AG-Schumann/Muon_Telescope_Remote_Control/docs/hardware/index.md

---
title: Hardware
nav_order: 2
has_children: true
---

# Hardware

The detector itself, and the control board that sits between it and the Raspberry Pi.
