AG-Schumann/Muon_Telescope_Remote_Control/docs/software/index.md

---
title: Software
nav_order: 3
has_children: true
---

# Software

A Python package in `software/`: a daemon that owns the hardware, a terminal UI that talks to it over a Unix socket, and the drivers underneath. Python 3.11+, installed into a virtual environment on the Pi.
