AG-Schumann/Muon_Telescope_Remote_Control/hardware/Schematics/Electronics/Board_Desing/Front Panel Desing.pptx

## Muon Telescope Control Board NIM Front Panel Desing

## Slide 2
