AG-Schumann/Muon_Telescope_Remote_Control/hardware/Schematics/Electronics/Board_Desing/Atmospheric_Muons.png

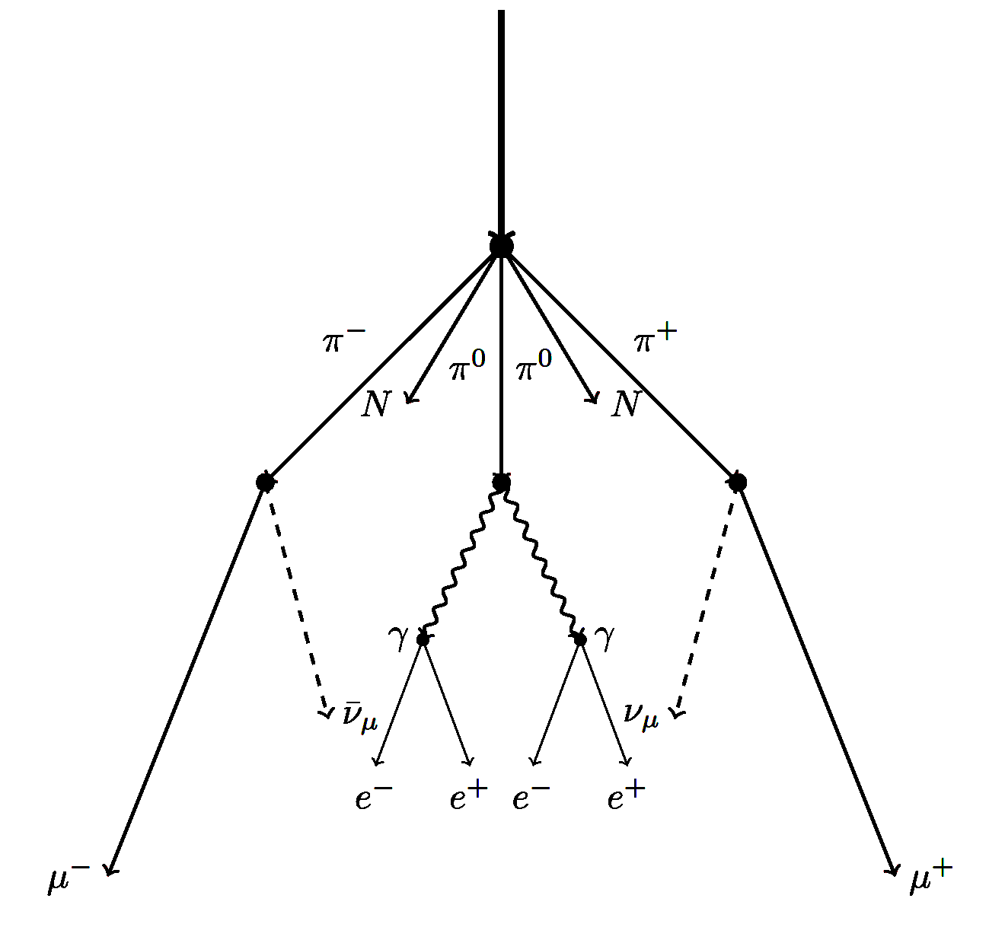
hardware/Schematics/Electronics/Board_Desing/Atmospheric_Muons.png
