AG-Schumann/Muon_Telescope_Remote_Control/hardware/Schematics/Frame_Movement/Bearing.jpg

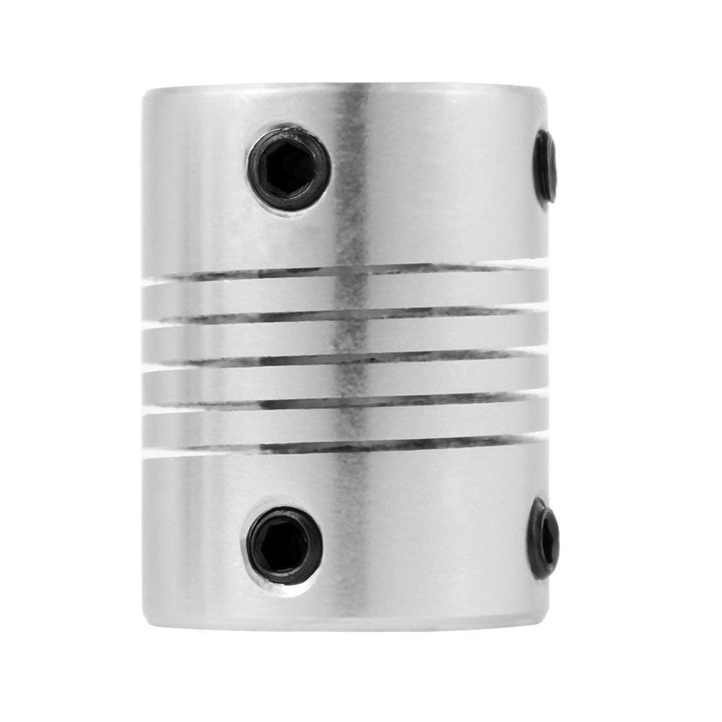
hardware/Schematics/Frame_Movement/Bearing.jpg
