AG-Schumann/Muon_Telescope_Remote_Control/hardware/Schematics/Frame_Movement/Drawing_1.jpeg

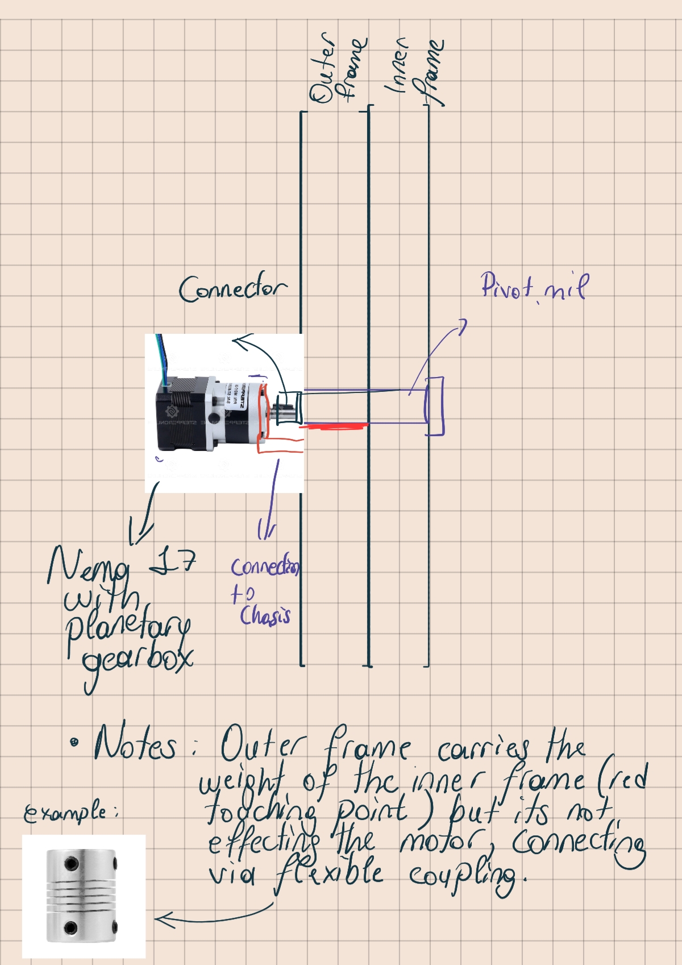
hardware/Schematics/Frame_Movement/Drawing_1.jpeg
