AG-Schumann/Muon_Telescope_Remote_Control/hardware/Schematics/Frame_Movement/Drawing_3.png

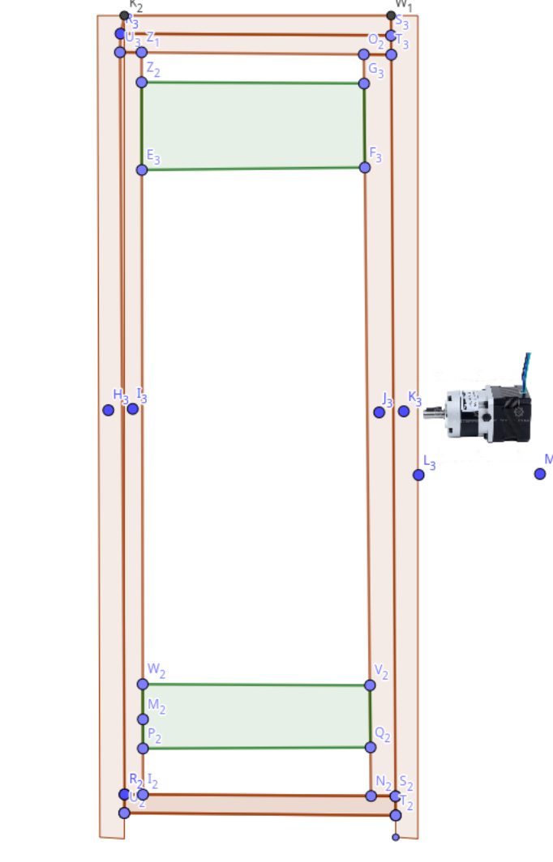
hardware/Schematics/Frame_Movement/Drawing_3.png
