AG-Schumann/Muon_Telescope_Remote_Control/hardware/Schematics/Frame_Movement/half view scintillator.png

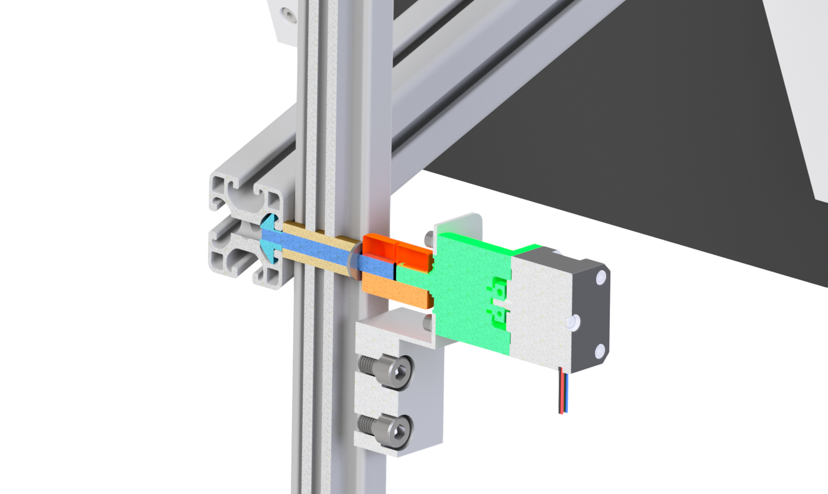
hardware/Schematics/Frame_Movement/half view scintillator.png
