AG-Schumann/Muon_Telescope_Remote_Control/hardware/Schematics/Frame_Movement/nema_17_with_gearbox_from_behind.jpg

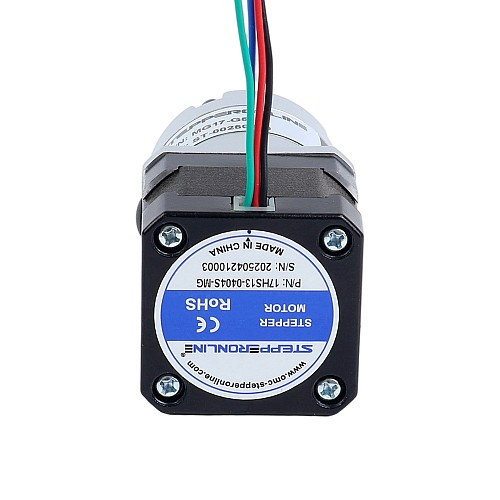
hardware/Schematics/Frame_Movement/nema_17_with_gearbox_from_behind.jpg
