AG-Schumann/Muon_Telescope_Remote_Control/hardware/Schematics/Frame_Movement/Rotating_System_Muon_Telescope.png

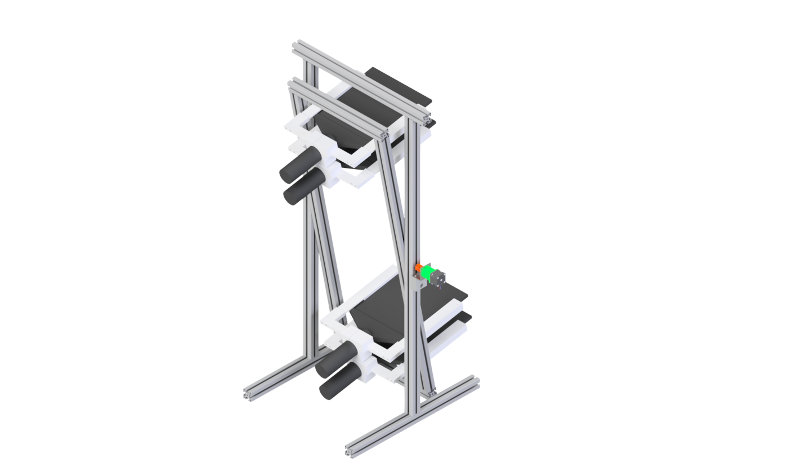
hardware/Schematics/Frame_Movement/Rotating_System_Muon_Telescope.png
