AG-Schumann/Muon_Telescope_Remote_Control/hardware/Schematics/Frame_Movement/scintillator shaft 2.png

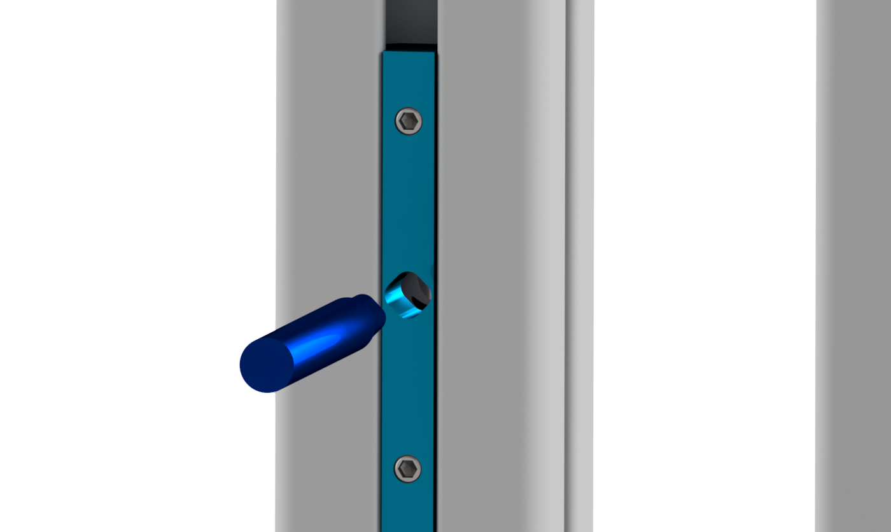
hardware/Schematics/Frame_Movement/scintillator shaft 2.png
