AG-Schumann/Muon_Telescope_Remote_Control/hardware/Schematics/Frame_Movement/view shaft.png

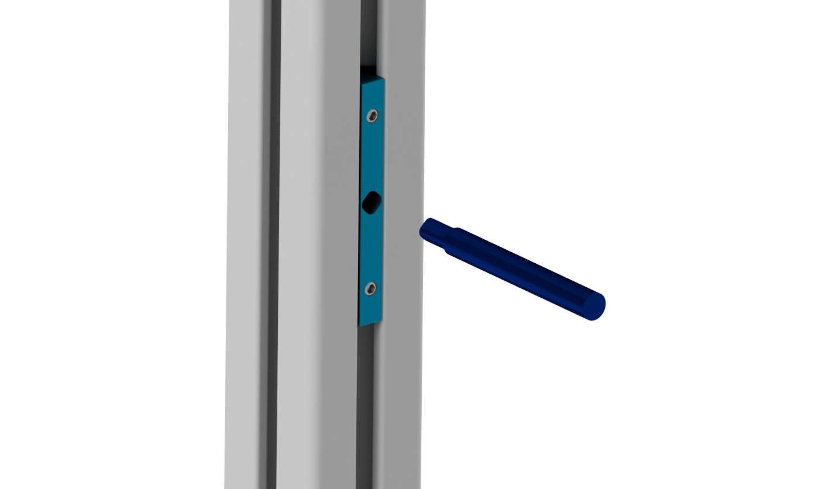
hardware/Schematics/Frame_Movement/view shaft.png
