AG-Schumann/Muon_Telescope_Remote_Control/hardware/Schematics/Measurement Setup/setup_images/ej-200-spec.jpg

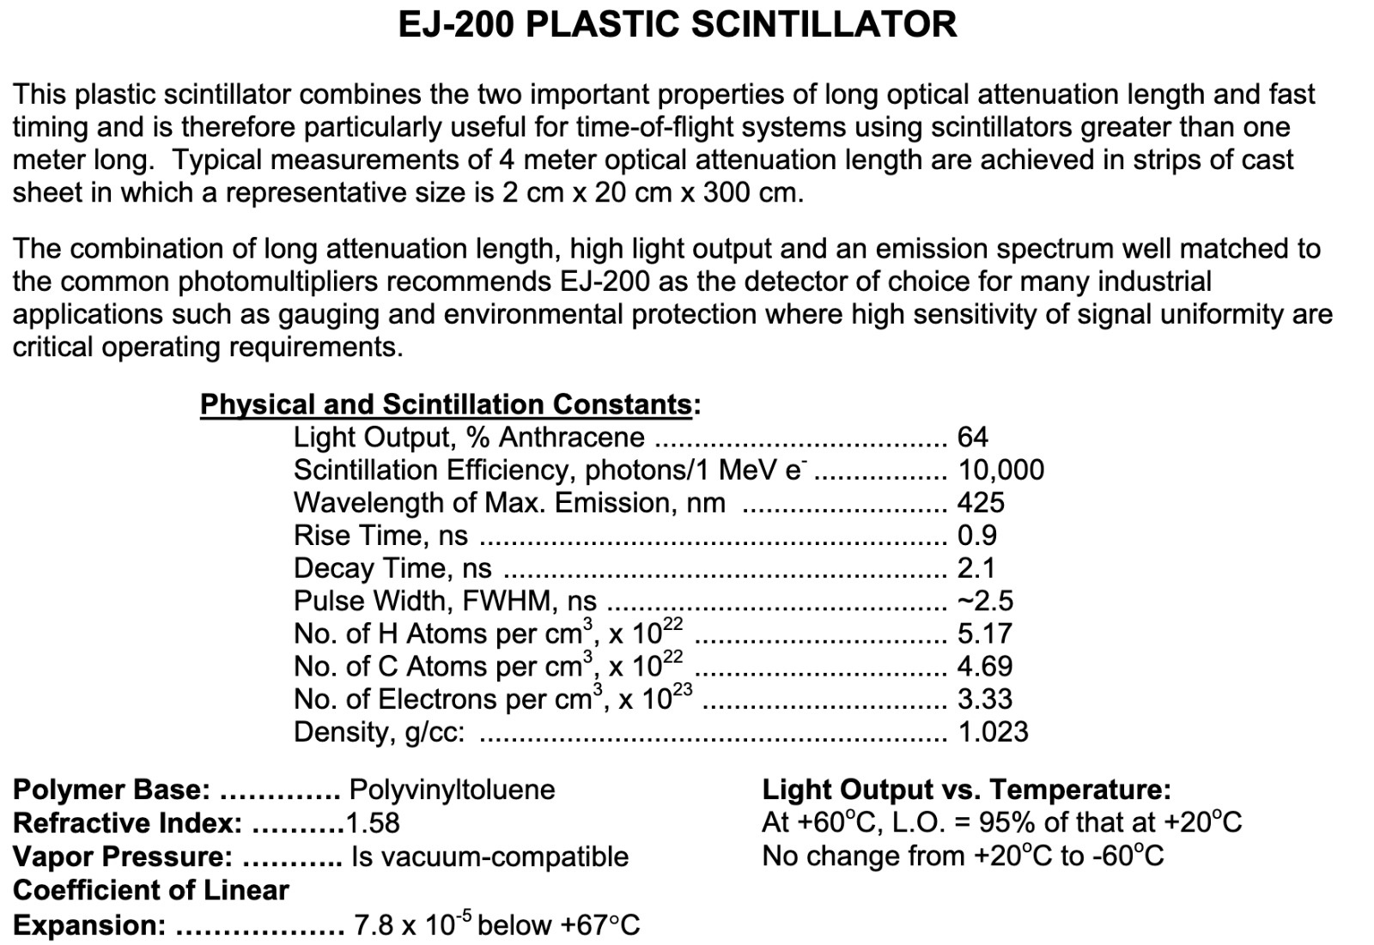
hardware/Schematics/Measurement Setup/setup_images/ej-200-spec.jpg
