AG-Schumann/Muon_Telescope_Remote_Control/hardware/Schematics/Electronics/Board_Desing/Board_Desing_V4.csv

Value | Reference | Footprint | Datasheet
33R | R13,R15 | Resistor_THT:R_Axial_DIN0207_L6.3mm_D2.5mm_P10.16mm_Horizontal
50R | R3,R14 | Resistor_THT:R_Axial_DIN0207_L6.3mm_D2.5mm_P10.16mm_Horizontal
100 nF | C2,C3,C4,C5,C6,C7 | Capacitor_THT:C_Disc_D5.0mm_W2.5mm_P5.00mm
330R | R8 | Resistor_THT:R_Axial_DIN0207_L6.3mm_D2.5mm_P10.16mm_Horizontal
470R | R10,R11,R12 | Resistor_THT:R_Axial_DIN0207_L6.3mm_D2.5mm_P10.16mm_Horizontal
1K | R4,R5,R6,R16,R17,R18,R20,R21,R22,R25,R26 | Resistor_THT:R_Axial_DIN0207_L6.3mm_D2.5mm_P10.16mm_Horizontal
10K | R23,R24,R27 | Resistor_THT:R_Axial_DIN0207_L6.3mm_D2.5mm_P10.16mm_Horizontal
2N7000 | Q1,Q2,Q3,Q4 | Package_TO_SOT_THT:TO-92 | https://www.vishay.com/docs/70226/70226.pdf
BAT85 | D1,D3 | Diode_THT:D_DO-34_SOD68_P7.62mm_Horizontal
BMI_Sensor_Conn | J2 | Connector_PinSocket_2.54mm:PinSocket_1x04_P2.54mm_Vertical
Coaxial_0 | J1 | Connector_Coaxial:LEMO-EPL.00.250.NTN
Coaxial_1 | J16 | Connector_Coaxial:LEMO-EPL.00.250.NTN
DAQ_DBG_0_1 | J14 | Connector_PinHeader_2.54mm:PinHeader_1x02_P2.54mm_Vertical
DAQ_DBG_0_2 | J15 | Connector_PinHeader_2.54mm:PinHeader_1x02_P2.54mm_Vertical
DAQ_DBG_1_1 | J17 | Connector_PinHeader_2.54mm:PinHeader_1x02_P2.54mm_Vertical
DAQ_DBG_1_2 | J18 | Connector_PinHeader_2.54mm:PinHeader_1x02_P2.54mm_Vertical
Driver_Socket | J19 | Connector_PinHeader_2.54mm:PinHeader_1x05_P2.54mm_Vertical
Front_Panel_Button_Conn | J10 | Connector_PinSocket_2.54mm:PinSocket_1x05_P2.54mm_Vertical
Front_Panel_Motor_Led_Conn | J11 | Connector_PinHeader_2.54mm:PinHeader_1x02_P2.54mm_Vertical
Front_Panel_Status_Led_Conn | J12 | Connector_PinSocket_2.54mm:PinSocket_1x04_P2.54mm_Vertical
Front_Panel_Toggle_Switch_Conn | J3 | Connector_PinHeader_2.54mm:PinHeader_1x02_P2.54mm_Vertical
GPIO | J8 | Connector_PinSocket_2.54mm:PinSocket_2x20_P2.54mm_Vertical
I2C_LCD_Conn | J13 | Connector_PinSocket_2.54mm:PinSocket_1x04_P2.54mm_Vertical
I2C_Temp_Conn | J20 | Connector_PinSocket_2.54mm:PinSocket_1x04_P2.54mm_Vertical
LIMIT_SWITCH_SET_0 | J4 | Connector_PinHeader_2.54mm:PinHeader_1x03_P2.54mm_Vertical
LIMIT_SWITCH_SET_MAX | J6 | Connector_PinHeader_2.54mm:PinHeader_1x03_P2.54mm_Vertical
P6KE6.8A | D2 | Diode_THT:D_DO-15_P10.16mm_Horizontal
Screw_Terminal_01x02 | J9 | TerminalBlock_Phoenix:TerminalBlock_Phoenix_MKDS-3-2-5.08_1x02_P5.08mm_Horizontal
SN74LVC1G14DBV | U1,U2 | Package_TO_SOT_SMD:SOT-23-5_HandSoldering | https://www.ti.com/lit/ds/symlink/sn74lvc1g14.pdf
Temp_Conn | J5 | Connector_PinHeader_2.54mm:PinHeader_1x03_P2.54mm_Vertical
