AG-Schumann/Muon_Telescope_Remote_Control/hardware/Schematics/Measurement Setup/setup_images/Cable_Labels.ods

Label List
HV |  | PMT-OUT
CH-0 | CH-0 | P0-OUT | P0-OUT
CH-1 | CH-1 | P1-OUT | P1-OUT
CH-2 | CH-2 | P2-OUT | P2-OUT
CH-3 | CH-3 | P3-OUT | P3-OUT
DISC->SCALER |  | PMT-OUT
P0-SC0 | P0-SC0 | P0-OUT | P0-OUT
P1-SC1 | P1-SC1 | P1-OUT | P1-OUT
P2-SC2 | P2-SC2 | P2-OUT | P2-OUT
P3-SC3 | P3-SC3 | P3-OUT | P3-OUT
DISC->COINC-4FOLD |  | DISC->COINC-2FOLD
P0-AND-4F | P0-AND-4F | P0-AND-03F | P0-AND-03F
P1-AND-4F | P1-AND-4F | P3-AND-03F | P3-AND-03F
P2-AND-4F | P2-AND-4F | P1-AND-12F | P1-AND-12F
P3-AND-4F | P3-AND-4F | P2-AND-12F | P2-AND-12F
FOLD-SCALER |  | 4F-PANEL-CONC
4F-SC | 4F-SC | 4F-AND-P1 | 4F-AND-P1
03F-SC | 03F-SC | P1-AND-4F | P1-AND-4F
12F-SC | 12F-SC | 4F-AND-P2 | 4F-AND-P2
4FP1-SC | 4FP1-SC | P2-AND-4F | P2-AND-4F
4FP2-SC | 4FP2-SC
