AG-Schumann/Muon_Telescope_Remote_Control/hardware/Schematics/Electronics/Board_Desing/Board_V2.stl

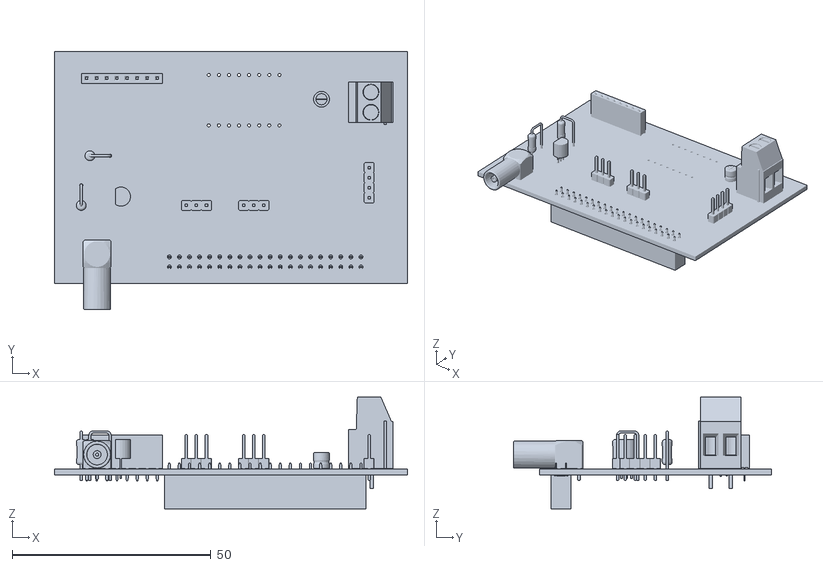
[picture p16: CAD file, 2026-10-29]
hardware/Schematics/Electronics/Board_Desing/Board_V2.stl
88.9 x 65.1 x 28.2
