AG-Schumann/Muon_Telescope_Remote_Control/hardware/Schematics/Frame_Movement/Models/Adapter für Steppermotor.stp

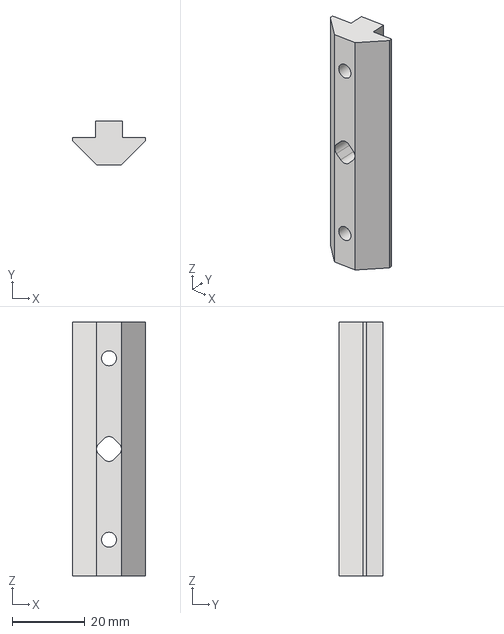
[picture p17: CAD file, 2026-10-29]
hardware/Schematics/Frame_Movement/Models/Adapter für Steppermotor.stp
20.0 x 12.0 x 70.0 mm
