AG-Schumann/Muon_Telescope_Remote_Control/hardware/Schematics/Frame_Movement/Models/Item 40x40x1200.stp

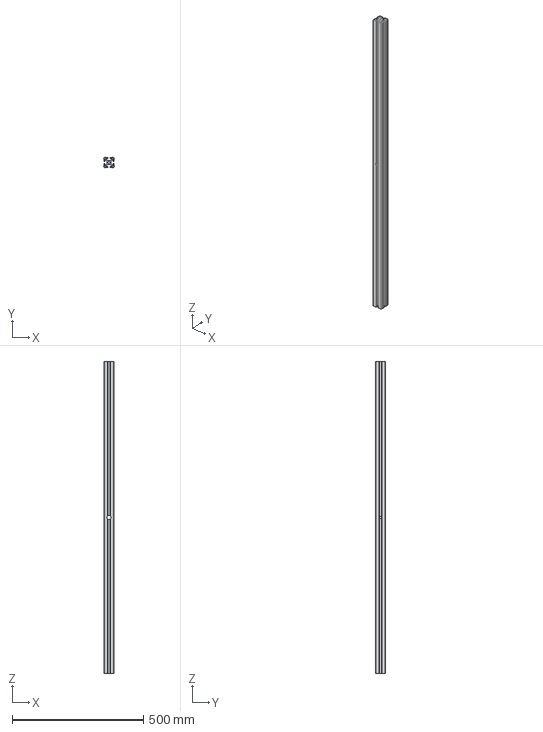
[picture p19: CAD file, 2026-10-29]
hardware/Schematics/Frame_Movement/Models/Item 40x40x1200.stp
40.0 x 40.0 x 1190.0 mm
