AG-Schumann/Muon_Telescope_Remote_Control/hardware/Schematics/Measurement Setup/Cad/RaspPi-4B.FCStd

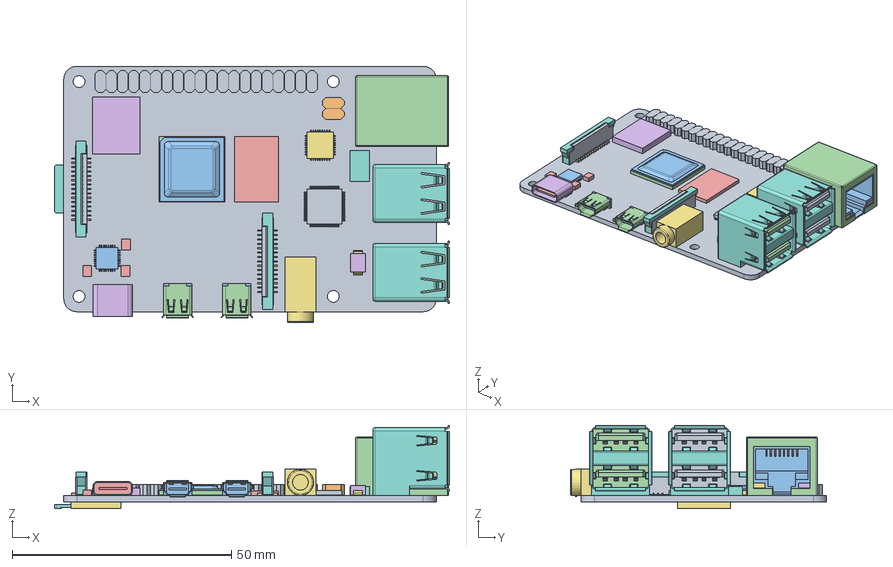
[picture p20: CAD file, 2026-10-29]
hardware/Schematics/Measurement Setup/Cad/RaspPi-4B.FCStd
90.1 x 58.5 x 19.0 mm
PCB
Chip Carrier
Heat Spreader
Solder
RAM (LPDDR4)
Radio
Package x 3
Pins x 6
Inductor x 3
Capacitor
Shield x 6
Network Wires
LED (yellow)
LED (green)
Pin Carrier x 2
Pins (Upper Connector) x 2
Pins (Lower Connector) x 2
Phone Socket (Audio/Video)
Holder x 2
SD Card Slot
Contacts
