AG-Schumann/Muon_Telescope_Remote_Control/hardware/Schematics/Frame_Movement/Models/Buchse Drehpunkt.stp

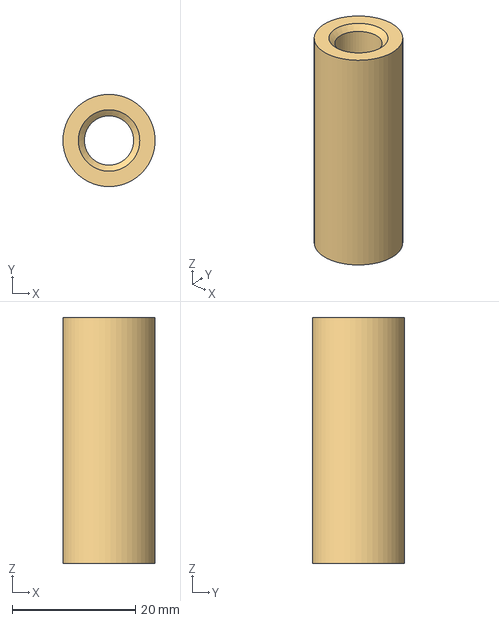
[picture p21: CAD file, 2026-10-29]
hardware/Schematics/Frame_Movement/Models/Buchse Drehpunkt.stp
15.0 x 15.0 x 40.0 mm
