AG-Schumann/Muon_Telescope_Remote_Control/hardware/Schematics/Measurement Setup/Cad/Muon_Detecotr.FCStd

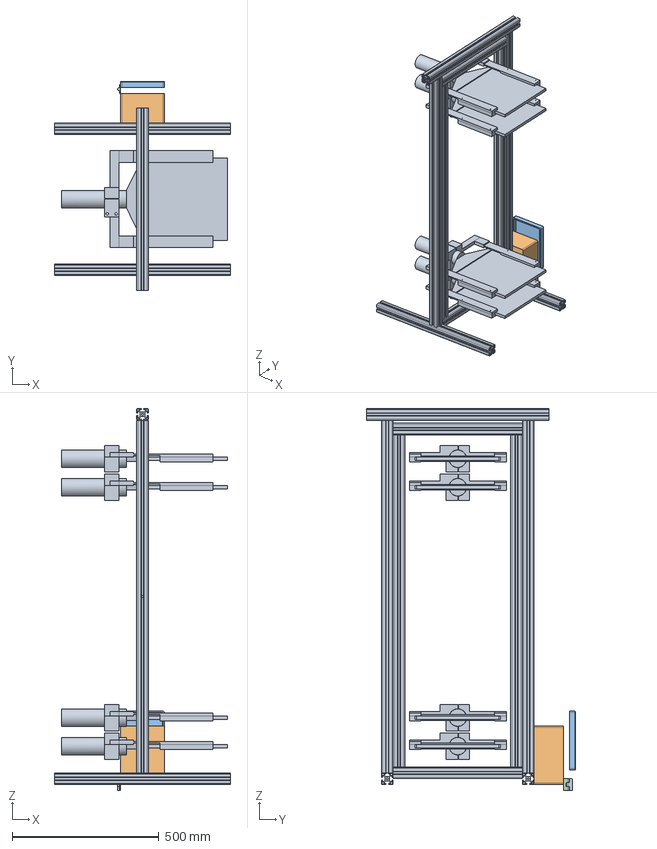
[picture p22: CAD file, 2026-10-29]
hardware/Schematics/Measurement Setup/Cad/Muon_Detecotr.FCStd
600.0 x 710.0 x 1300.0 mm
Scintillator group
Bottom_Part
Top_Part
Hinge_1
Hinge_2
Hinge_001
Hinge_002
Hinge_003
Hinge_004
