AG-Schumann/Muon_Telescope_Remote_Control/hardware/Schematics/Frame_Movement/Models/Drehteil Rotationswelle.stp

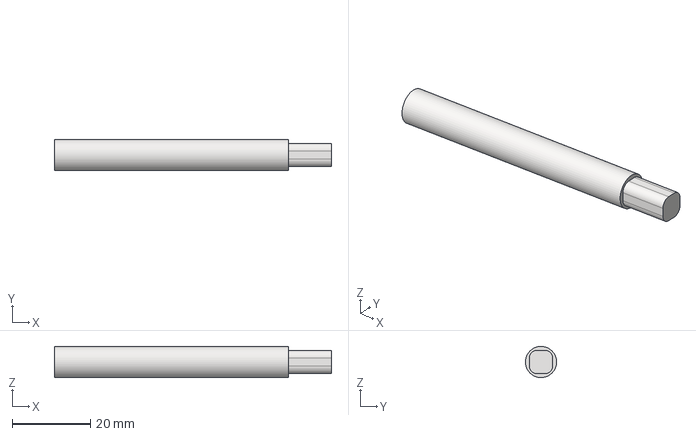
[picture p23: CAD file, 2026-10-29]
hardware/Schematics/Frame_Movement/Models/Drehteil Rotationswelle.stp
71.0 x 7.99 x 8.00 mm
