AG-Schumann/Muon_Telescope_Remote_Control/hardware/Schematics/Measurement Setup/Cad/TB6600.FCStd

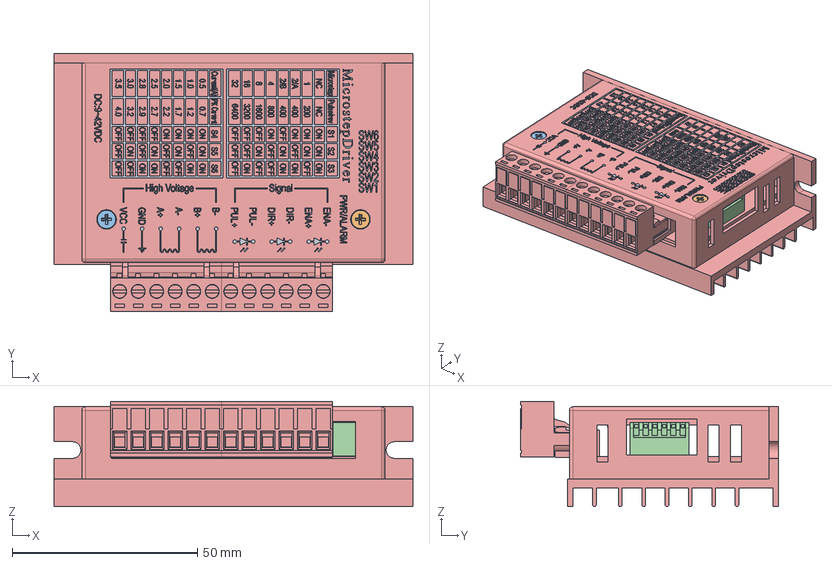
[picture p24: CAD file, 2026-10-29]
hardware/Schematics/Measurement Setup/Cad/TB6600.FCStd
97.0 x 69.6 x 28.5 mm
