AG-Schumann/Muon_Telescope_Remote_Control/(list of files, cad)

Other CAD files:
hardware/Schematics/Measurement Setup/Cad/Muon_Detector_Assembly.FCStd
hardware/Schematics/Electronics/Board_Desing/Board.FCStd
hardware/Schematics/Electronics/Board_Desing/TB6600.FCStd
hardware/Schematics/Measurement Setup/Cad/TB6600(AP203).step
