AG-Schumann/Muon_Telescope_Remote_Control/docs/operations/index.md

---
title: Operations
nav_order: 4
has_children: true
---

# Operations

Day-to-day running: monitoring, remote sessions, fetching the code, and what to do when something stops working.
