AG-Schumann/Muon_Telescope_Remote_Control/hardware/Schematics/Measurement Setup/setup_images/panel_layout_v2.pdf

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

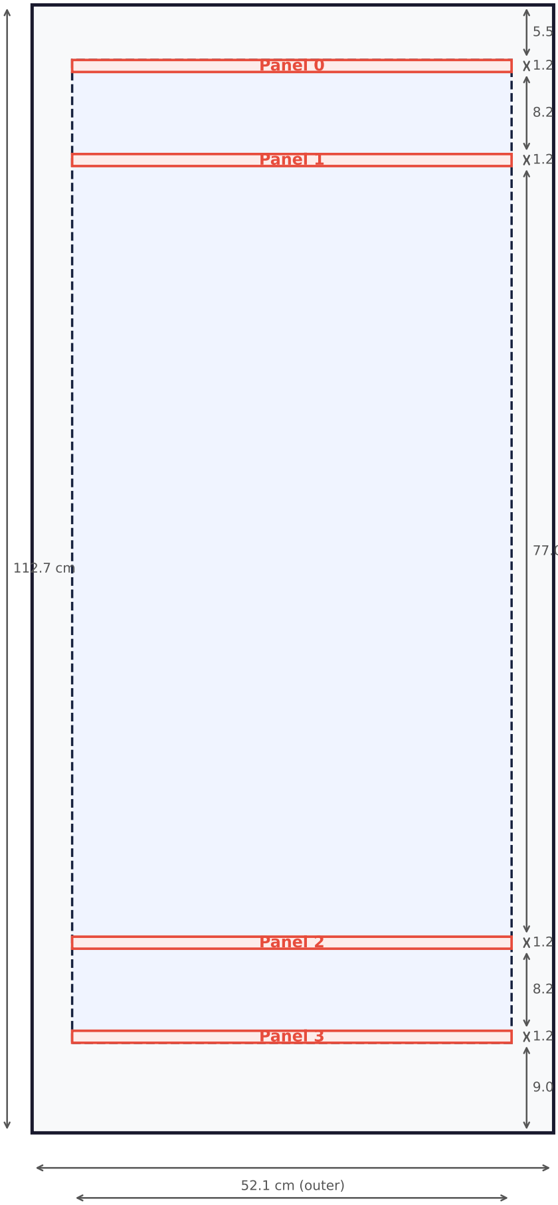
[picture p25: figure]
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
