AG-Schumann/Muon_Telescope_Remote_Control/hardware/Schematics/Measurement Setup/Cad/example_FC-View.png

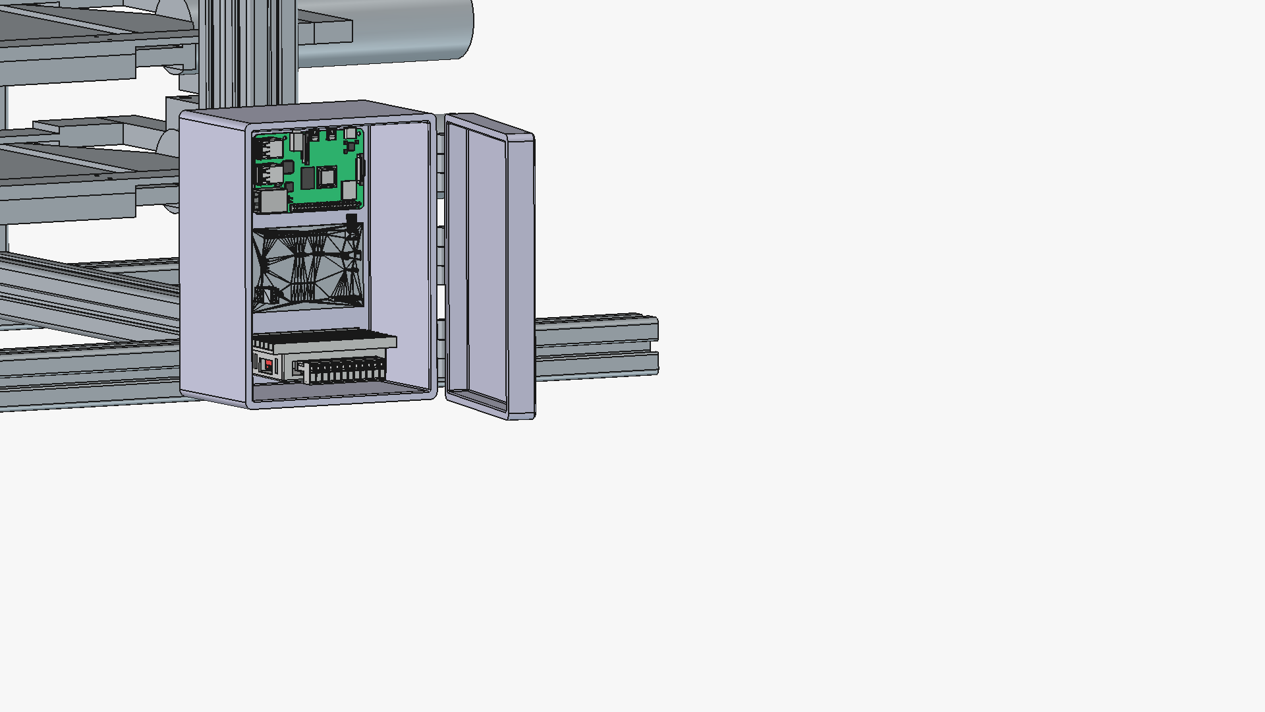
hardware/Schematics/Measurement Setup/Cad/example_FC-View.png
