AG-Schumann/Muon_Telescope_Remote_Control/hardware/Schematics/Measurement Setup/Cad/Outputs/Muon-Telescope-V2.png

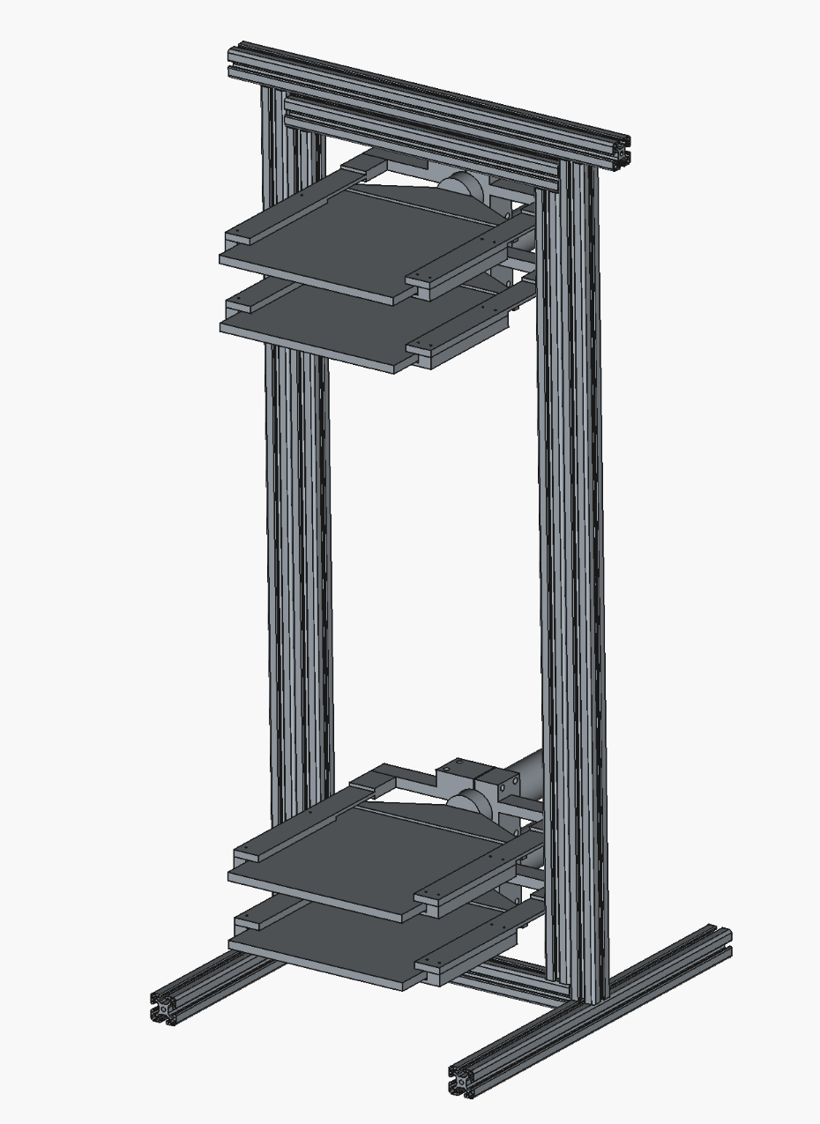
hardware/Schematics/Measurement Setup/Cad/Outputs/Muon-Telescope-V2.png
