AG-Schumann/Muon_Telescope_Remote_Control/hardware/Schematics/Measurement Setup/Cad/Outputs/Muon-Telescope-V2_4.jpg

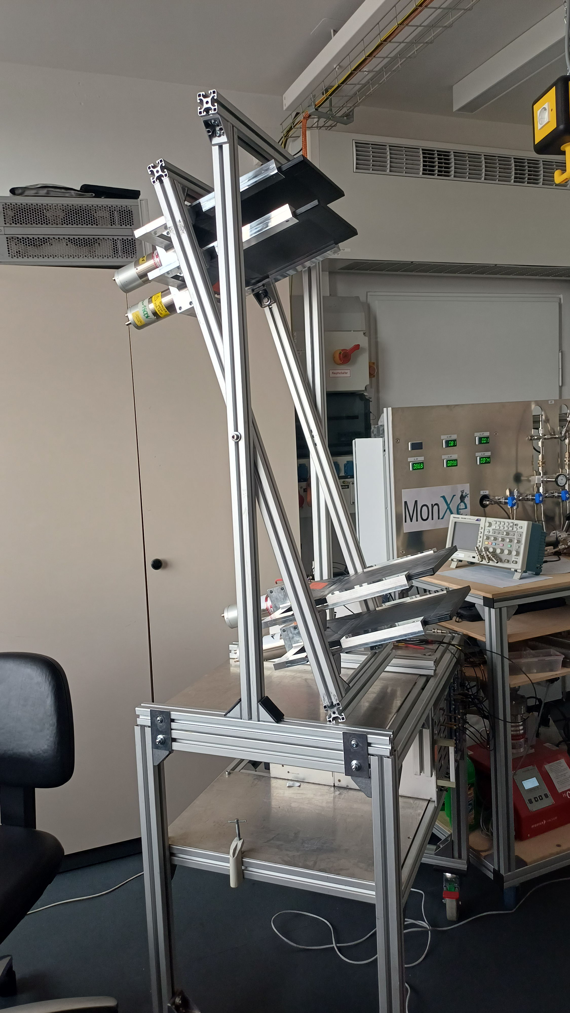
hardware/Schematics/Measurement Setup/Cad/Outputs/Muon-Telescope-V2_4.jpg
