AG-Schumann/Muon_Telescope_Remote_Control/hardware/Schematics/Measurement Setup/Panels/Panel_0/panel_0.jpg

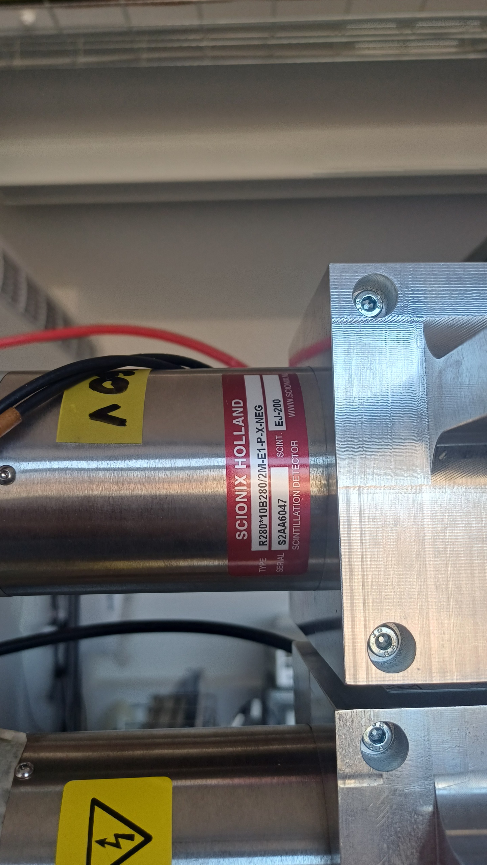
hardware/Schematics/Measurement Setup/Panels/Panel_0/panel_0.jpg
