AG-Schumann/Muon_Telescope_Remote_Control/hardware/Schematics/Measurement Setup/Panels/Panel_1/panel_1-1.png

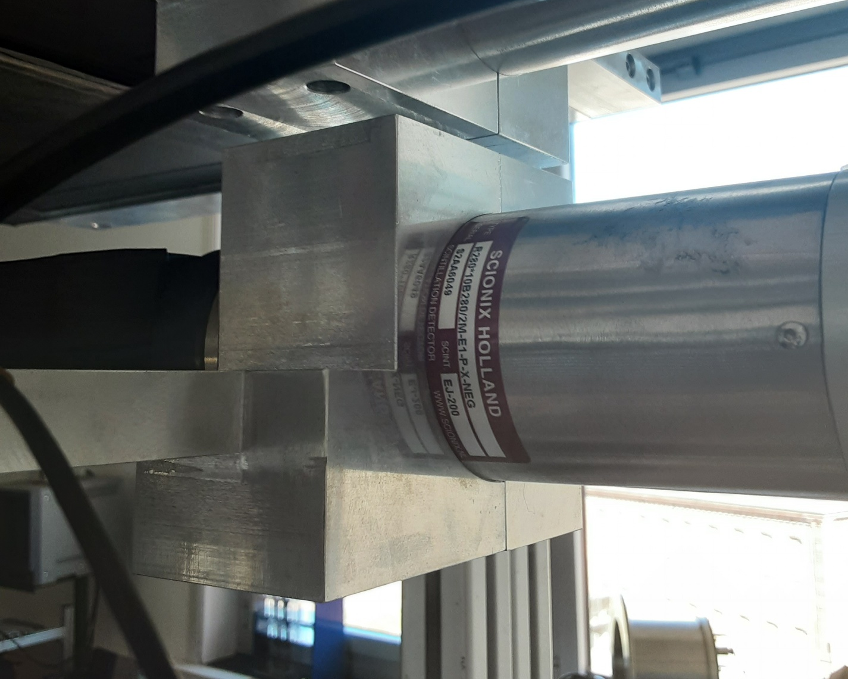
hardware/Schematics/Measurement Setup/Panels/Panel_1/panel_1-1.png
