AG-Schumann/Muon_Telescope_Remote_Control/hardware/Schematics/Measurement Setup/Panels/Panel_1/panel_1-2.png

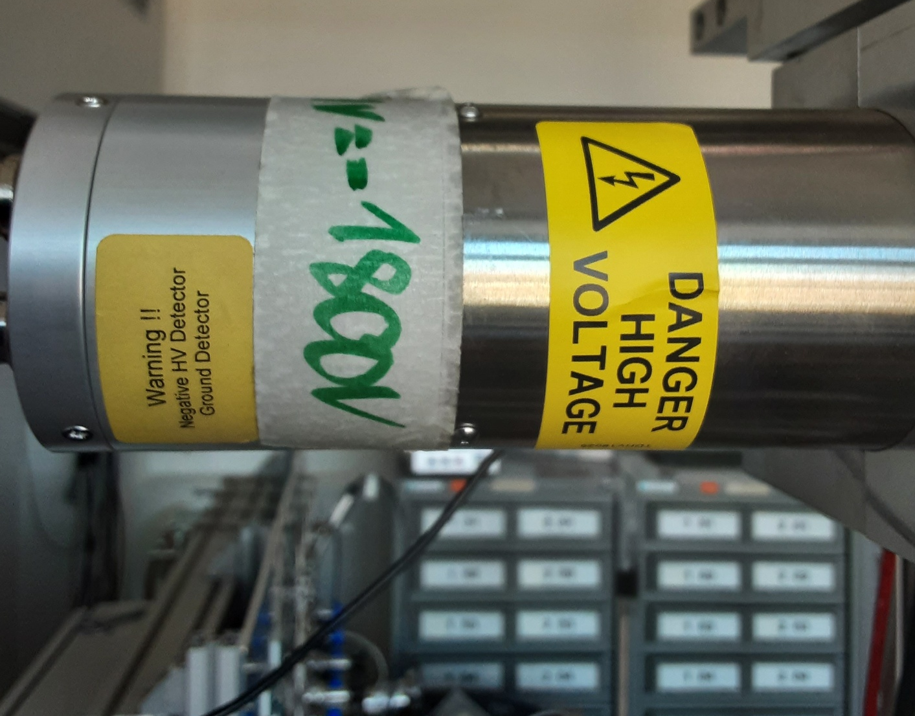
hardware/Schematics/Measurement Setup/Panels/Panel_1/panel_1-2.png
