AG-Schumann/Muon_Telescope_Remote_Control/hardware/Schematics/Measurement Setup/Panels/Panel_1/panel_1_muon_sig_osci_disc.jpeg

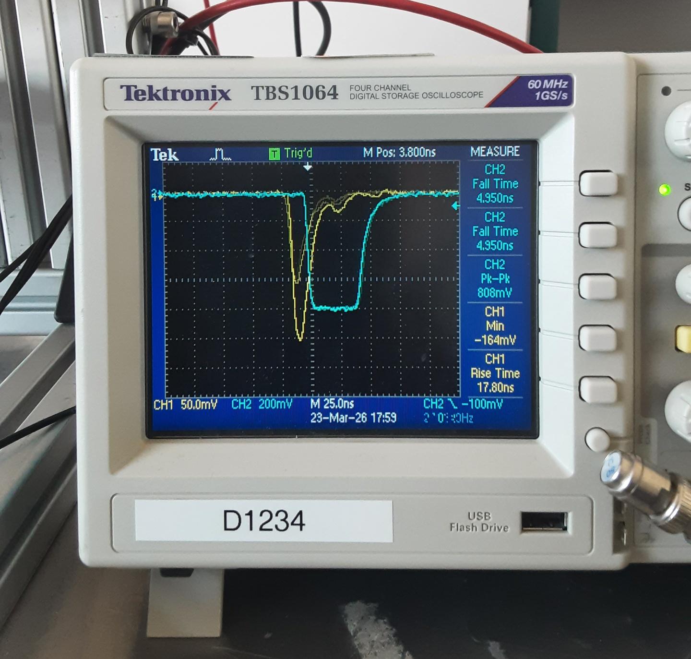
hardware/Schematics/Measurement Setup/Panels/Panel_1/panel_1_muon_sig_osci_disc.jpeg
