AG-Schumann/Muon_Telescope_Remote_Control/hardware/Schematics/Measurement Setup/Panels/Panel_2/panel_2-2.png

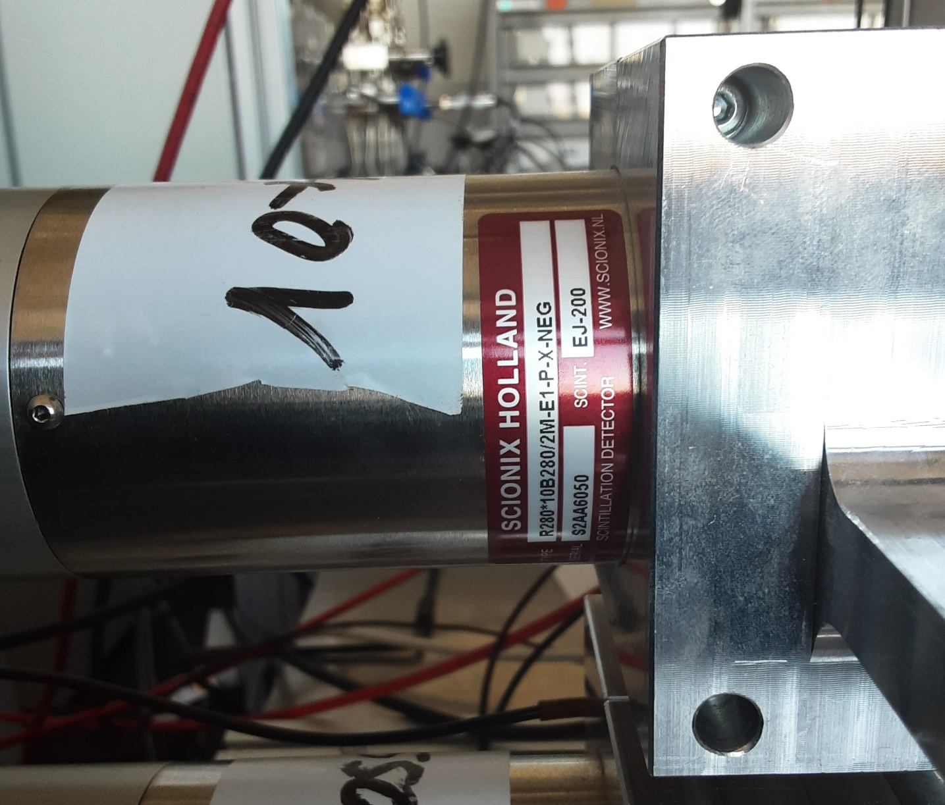
hardware/Schematics/Measurement Setup/Panels/Panel_2/panel_2-2.png
