AG-Schumann/Muon_Telescope_Remote_Control/hardware/Schematics/Measurement Setup/Panels/Panel_3/panel_3-2.png

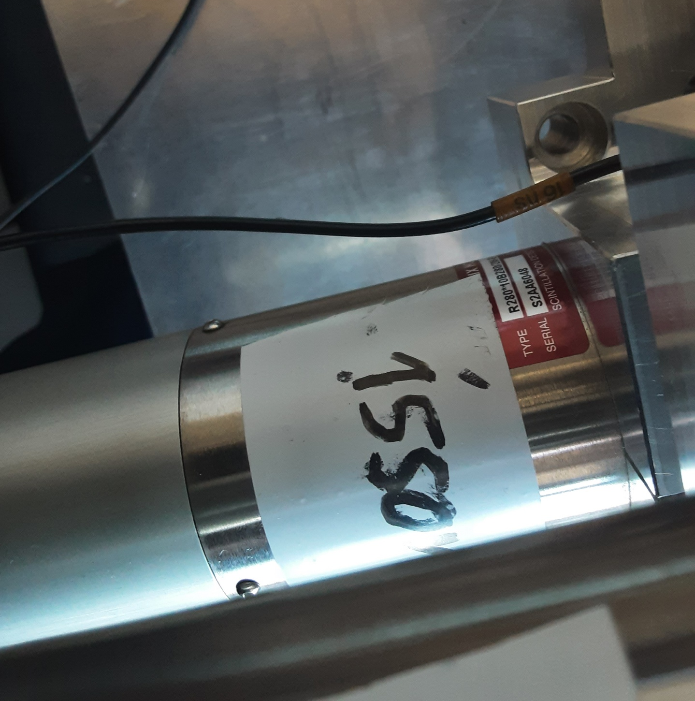
hardware/Schematics/Measurement Setup/Panels/Panel_3/panel_3-2.png
