AG-Schumann/Muon_Telescope_Remote_Control/hardware/Schematics/Measurement Setup/setup_images/daq.jpg

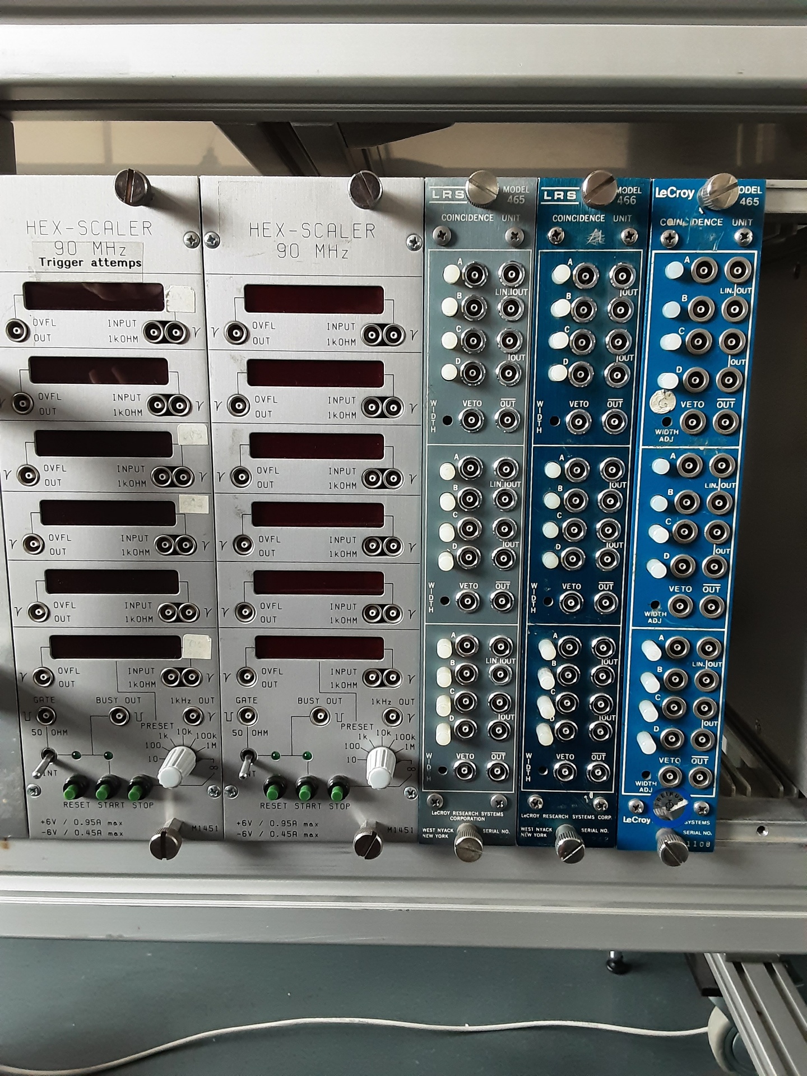
hardware/Schematics/Measurement Setup/setup_images/daq.jpg
