AG-Schumann/Muon_Telescope_Remote_Control/hardware/Schematics/Measurement Setup/setup_images/panel_layout_v2.png

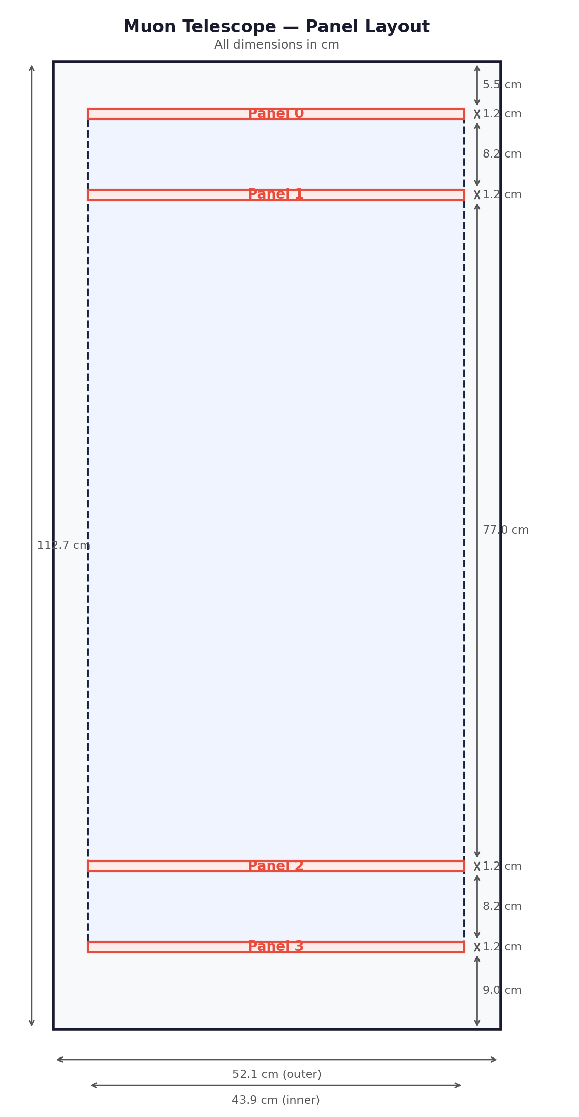
hardware/Schematics/Measurement Setup/setup_images/panel_layout_v2.png
