AG-Schumann/Muon_Telescope_Remote_Control/docs/measurements/index.md

---
title: Measurements
nav_order: 5
has_children: true
---

# Measurements

Bench measurements that characterise the instrument, with the numbers and the reasoning, so they can be cited rather than redone.
