AG-Schumann/Muon_Telescope_Remote_Control/hardware/Schematics/Measurement Setup/Muon_Measurement.md

# Muon Measurement Setup

This page has moved to the documentation site: https://AG-Schumann.github.io/Muon_Telescope_Remote_Control/hardware/telescope.html (source: `docs/hardware/telescope.md`). The drawings and photos it uses stay in this folder.
