AG-Schumann/Muon_Telescope_Remote_Control/hardware/Schematics/Electronics/Board_Desing/Board_Desing_V4.kicad_pcb

## KiCad design hardware/Schematics/Electronics/Board_Desing/Board_Desing_V4.kicad_pcb (2026-10-29)

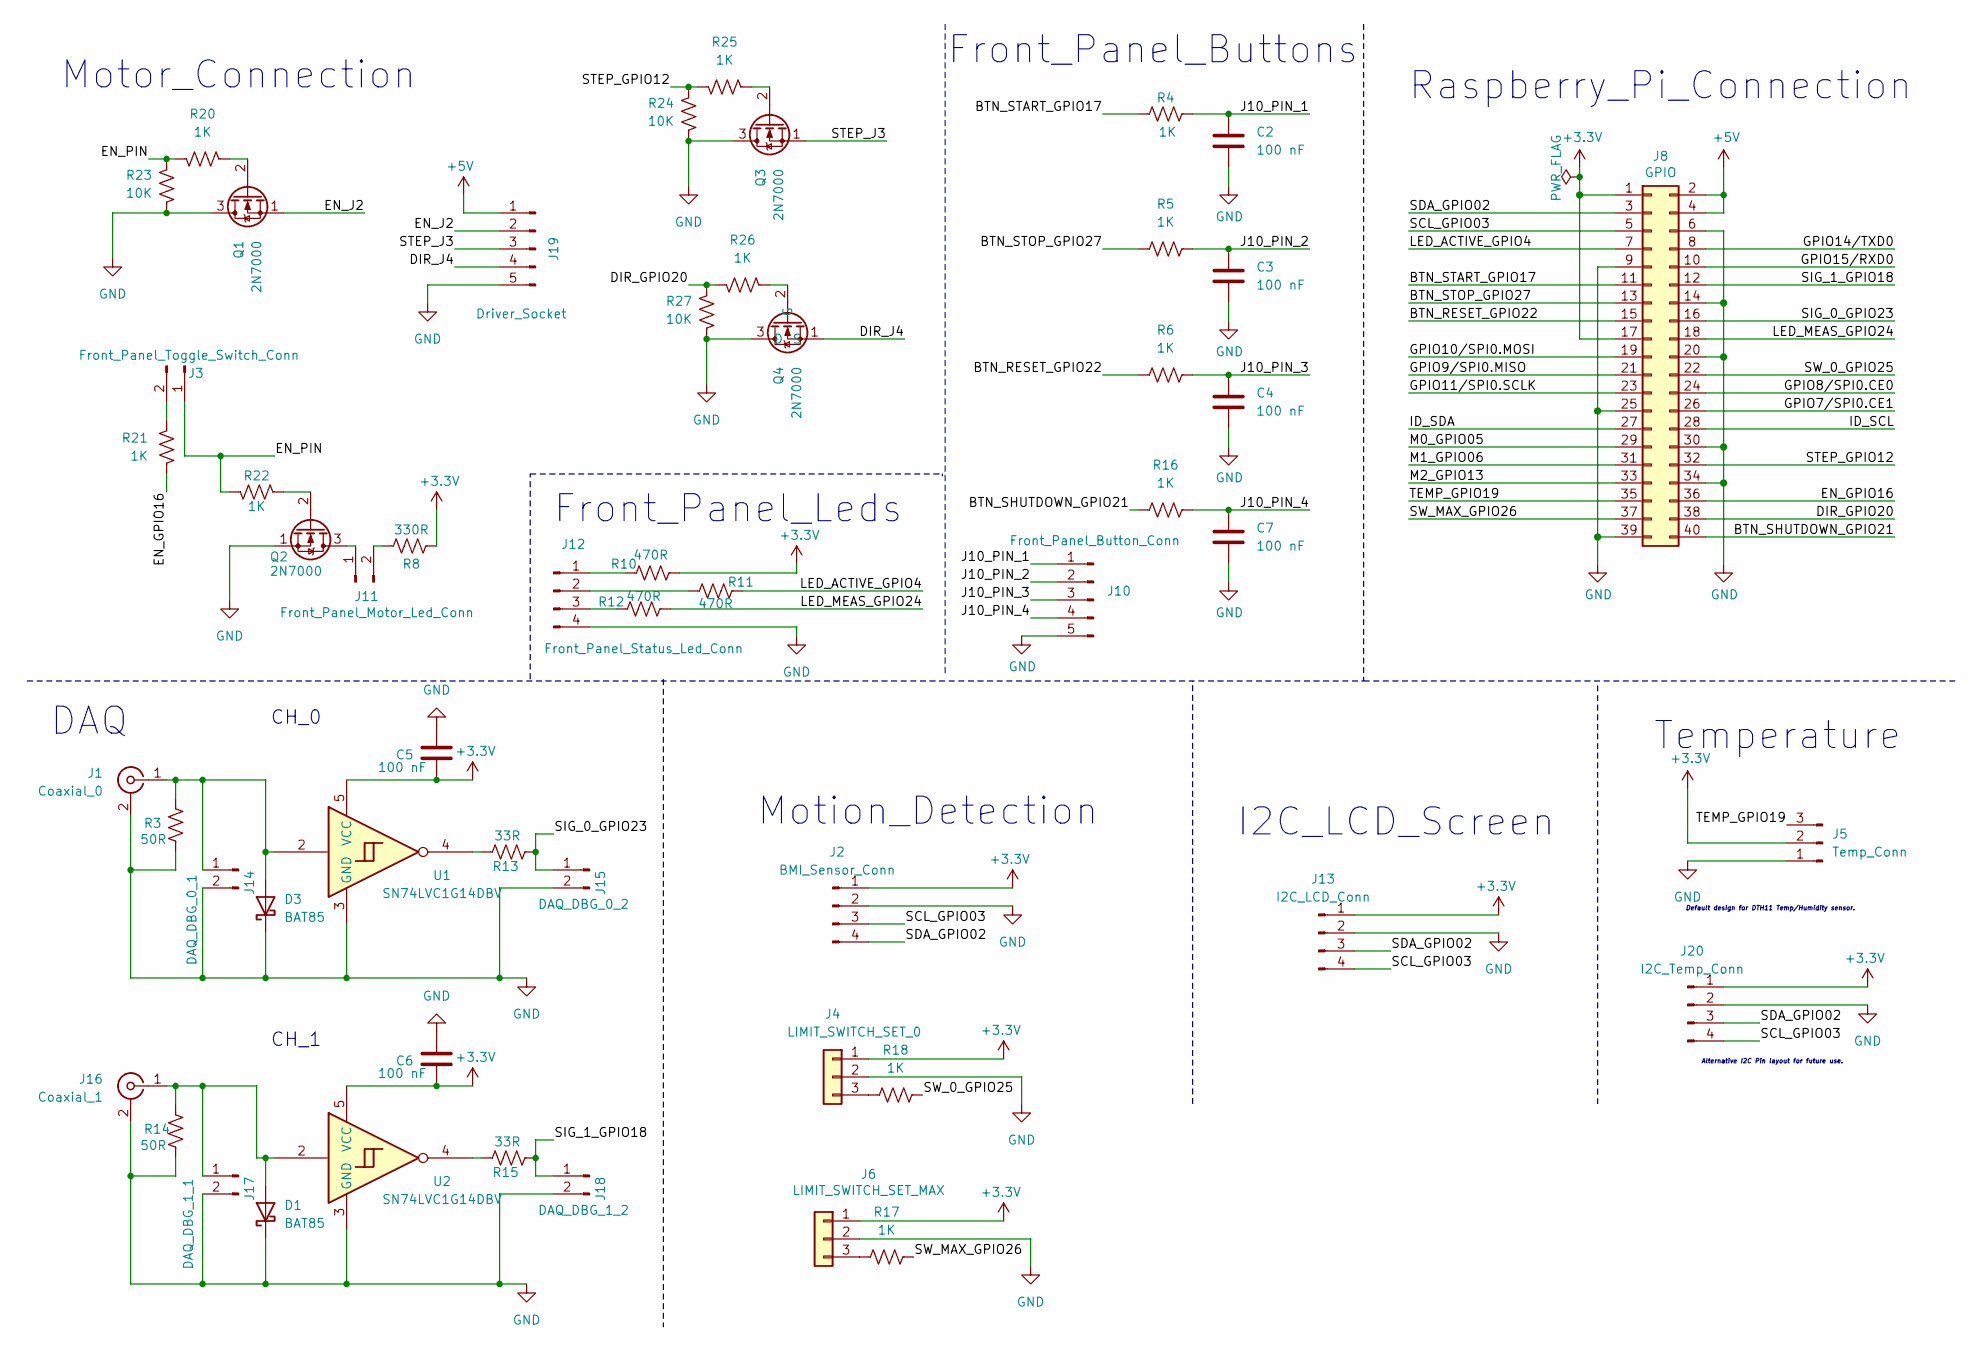
[picture p59: schematic Board_Desing_V4.kicad_sch, Muon_Telescope_Control_Board]

Parts:
C2, C3, C4, C5, C6, C7: 100 nF; C_Disc_D5.0mm_W2.5mm_P5.00mm
D1, D3: BAT85; D_DO-34_SOD68_P7.62mm_Horizontal
J1: Coaxial_0; LEMO-EPL.00.250.NTN
J2: BMI_Sensor_Conn; PinSocket_1x04_P2.54mm_Vertical
J3: Front_Panel_Toggle_Switch_Conn; PinHeader_1x02_P2.54mm_Vertical
J4: LIMIT_SWITCH_SET_0; PinHeader_1x03_P2.54mm_Vertical
J5: Temp_Conn; PinHeader_1x03_P2.54mm_Vertical
J6: LIMIT_SWITCH_SET_MAX; PinHeader_1x03_P2.54mm_Vertical
J8: GPIO; PinSocket_2x20_P2.54mm_Vertical
J10: Front_Panel_Button_Conn; PinSocket_1x05_P2.54mm_Vertical
J11: Front_Panel_Motor_Led_Conn; PinHeader_1x02_P2.54mm_Vertical
J12: Front_Panel_Status_Led_Conn; PinSocket_1x04_P2.54mm_Vertical
J13: I2C_LCD_Conn; PinSocket_1x04_P2.54mm_Vertical
J14: DAQ_DBG_0_1; PinHeader_1x02_P2.54mm_Vertical
J15: DAQ_DBG_0_2; PinHeader_1x02_P2.54mm_Vertical
J16: Coaxial_1; LEMO-EPL.00.250.NTN
J17: DAQ_DBG_1_1; PinHeader_1x02_P2.54mm_Vertical
J18: DAQ_DBG_1_2; PinHeader_1x02_P2.54mm_Vertical
J19: Driver_Socket; PinHeader_1x05_P2.54mm_Vertical
J20: I2C_Temp_Conn; PinSocket_1x04_P2.54mm_Vertical
Q1, Q2, Q3, Q4: 2N7000; TO-92
R3, R14: 50R; R_Axial_DIN0207_L6.3mm_D2.5mm_P10.16mm_Horizontal
R4, R5, R6, R16, R17, R18, R20, R21, R22, R25, R26: 1K; R_Axial_DIN0207_L6.3mm_D2.5mm_P10.16mm_Horizontal
R8: 330R; R_Axial_DIN0207_L6.3mm_D2.5mm_P10.16mm_Horizontal
R10, R11, R12: 470R; R_Axial_DIN0207_L6.3mm_D2.5mm_P10.16mm_Horizontal
R13, R15: 33R; R_Axial_DIN0207_L6.3mm_D2.5mm_P10.16mm_Horizontal
R23, R24, R27: 10K; R_Axial_DIN0207_L6.3mm_D2.5mm_P10.16mm_Horizontal
U1, U2: SN74LVC1G14DBV; SOT-23-5_HandSoldering

Connections:
+3.3V: C5.1, C6.1, J2.1, J4.1, J5.2, J6.1, J8.1, J8.17, J13.1, J20.1, R8.1, R10.2, U1.5 (VCC), U2.5 (VCC)
+5V: J8.2, J8.4, J19.1; also elsewhere on the board
/BTN_RESET_GPIO22: J8.15, R6.1
/BTN_SHUTDOWN_GPIO21: J8.40, R16.1
/BTN_START_GPIO17: J8.11, R4.1
/BTN_STOP_GPIO27: J8.13, R5.1
/DIR_GPIO20: J8.38, R26.2, R27.1
/DIR_J4: J19.4, Q4.1 (S)
/EN_GPIO16: J8.36, R21.1
/EN_J2: J19.2, Q1.1 (S)
/EN_PIN: J3.1, R20.2, R22.2, R23.1
/GPIO7/SPI0.CE1: J8.26
/GPIO8/SPI0.CE0: J8.24
/GPIO9/SPI0.MISO: J8.21
/GPIO10/SPI0.MOSI: J8.19
/GPIO11/SPI0.SCLK: J8.23
/GPIO14/TXD0: J8.8
/GPIO15/RXD0: J8.10
/ID_SCL: J8.28
/ID_SDA: J8.27
/J10_PIN_1: C2.1, J10.1, R4.2
/J10_PIN_2: C3.1, J10.2, R5.2
/J10_PIN_3: C4.1, J10.3, R6.2
/J10_PIN_4: C7.1, J10.4, R16.2
/LED_ACTIVE_GPIO4: J8.7, R11.2
/LED_MEAS_GPIO24: J8.18, R12.2
/M0_GPIO05: J8.29
/M1_GPIO06: J8.31
/M2_GPIO13: J8.33
/SCL_GPIO03: J2.3, J8.5, J13.4, J20.4
/SDA_GPIO02: J2.4, J8.3, J13.3, J20.3
/SIG_0_GPIO23: J8.16, J15.1, R13.1
/SIG_1_GPIO18: J8.12, J18.1, R15.1
/STEP_GPIO12: J8.32, R24.1, R25.2
/STEP_J3: J19.3, Q3.1 (S)
/SW_0_GPIO25: J8.22, R18.2
/SW_MAX_GPIO26: J8.37, R17.2
/TEMP_GPIO19: J5.3, J8.35
GND: C2.2, C3.2, C4.2, C5.2, C6.2, C7.2, D1.1 (K), D3.1 (K), J1.2 (Ext), J2.2, J4.2, J5.1, J6.2, J8.6, J8.9, J8.14, J8.20, J8.25, J8.30, J8.34, J8.39, J10.5, J12.4, J13.2, J14.2, J15.2, J16.2 (Ext), J17.2, J18.2, J19.5, J20.2, Q1.3 (D), Q2.1 (S), Q3.3 (D), Q4.3 (D), R3.1, R14.1, R23.2, R24.2, R27.2, U1.3 (GND), U2.3 (GND); also elsewhere on the board
unnamed: D1.2 (A), J16.1 (In), J17.1, R14.2, U2.2
unnamed: D3.2 (A), J1.1 (In), J14.1, R3.2, U1.2
unnamed: J3.2, R21.2
unnamed: J4.3, R18.1
unnamed: J6.3, R17.1
unnamed: J11.1, Q2.3 (D)
unnamed: J11.2, R8.2
unnamed: J12.1, R10.1
unnamed: J12.2, R11.1
unnamed: J12.3, R12.1
unnamed: Q1.2 (G), R20.1
unnamed: Q2.2 (G), R22.1
unnamed: Q3.2 (G), R25.1
unnamed: Q4.2 (G), R26.1
unnamed: R13.2, U1.4
unnamed: R15.2, U2.4

Notes on the sheet:
CH_0
Front_Panel_Leds
Raspberry_Pi_Connection
Temperature
Front_Panel_Buttons
Motion_Detection
I2C_LCD_Screen
DAQ
Alternative I2C Pin layout for future use.
Motor_Connection
CH_1
Default design for DTH11 Temp/Humidity sensor.

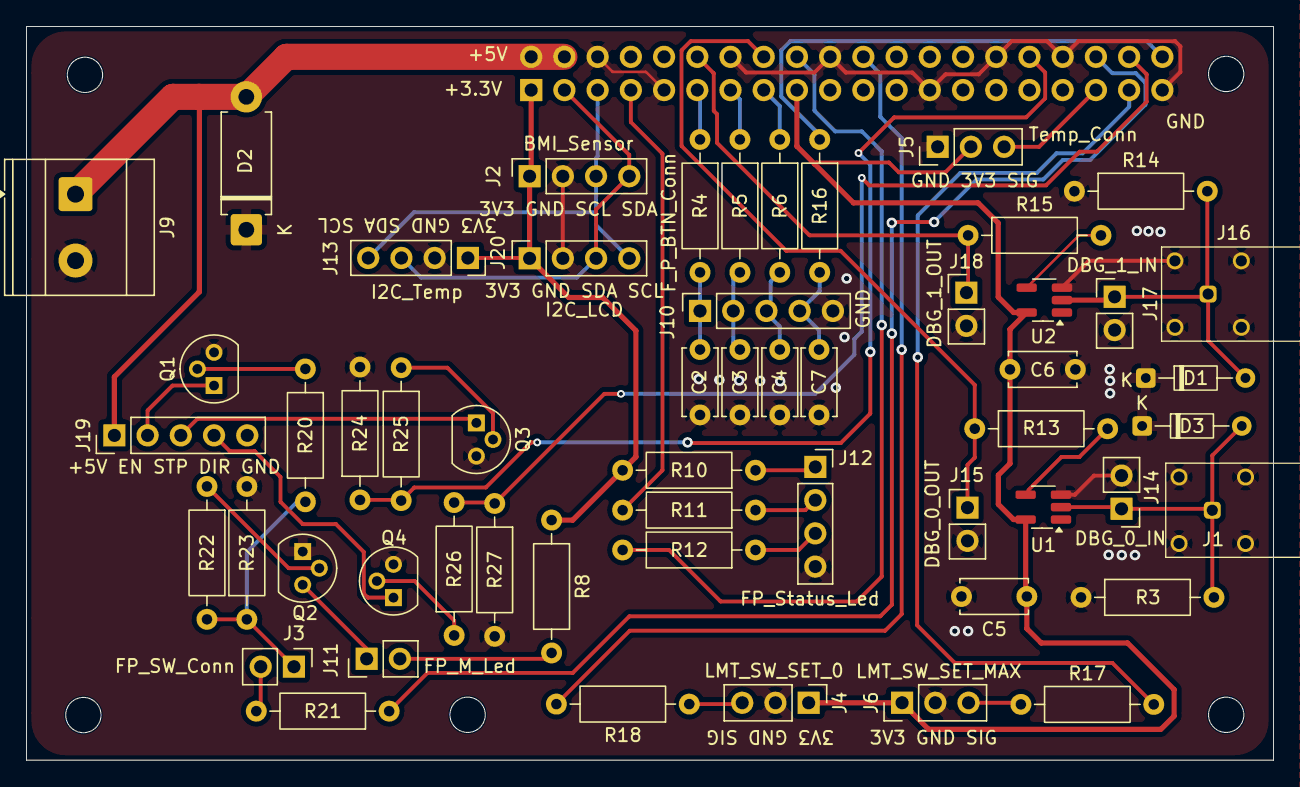
[picture p60: board Board_Desing_V4.kicad_pcb from above]

Board: 2 copper layers, 95.3 x 56.1 mm, 61 parts (1 on the bottom side), 43 nets.

Other parts of the board:
D2: P6KE6.8A; D_DO-15_P10.16mm_Horizontal
J9: Screw_Terminal_01x02; TerminalBlock_Phoenix_MKDS-3-2-5.08_1x02_P5.08mm_Horizontal
MH2, MH3, MH3#2, MH3#3, MH4: MountingHole_2.7mm_M2.5

Their connections:
+5V: D2.2 (A2), J9.1; also elsewhere on the board
GND: D2.1 (A1), J9.2; also elsewhere on the board
